viordash/PSoC5-PowerSupplyUnit/README.md

# PowerSupplyUnit PSoC5
Источник питания с микропроцессорным управлением, процессор PSoC® 5LP: CY8C5888LTI-LP097

[схема!](PSoC5_PowerSuplyUnit_Schematic.pdf)

Основные возможности блока питания:
- Два режима работы:

    - Стабилизация выходного напряжения.
    - Стабилизация выходного тока.

- Дискретность по напряжению - 0.01 В.
- Дискретность по току - 0.001 А.
- Выходное напряжение, 2 канала по 0-15 В.
- Максимальный выходной ток, до 8 А.

Управление с передней панели и с помощью манипулятора "мышь" PS/2
Отображение информации на графическом LCD дисплее 240x128 точек

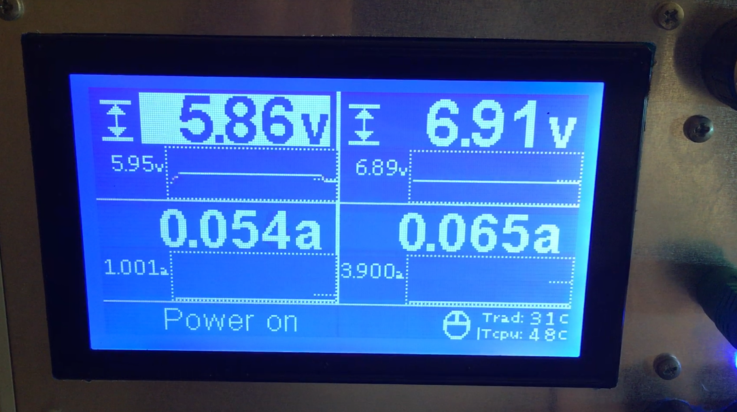
[picture p1: Photo/front panel.png]
front-panel
