viordash/PSoC5-PowerSupplyUnit/Photo/IMG_0879.JPG

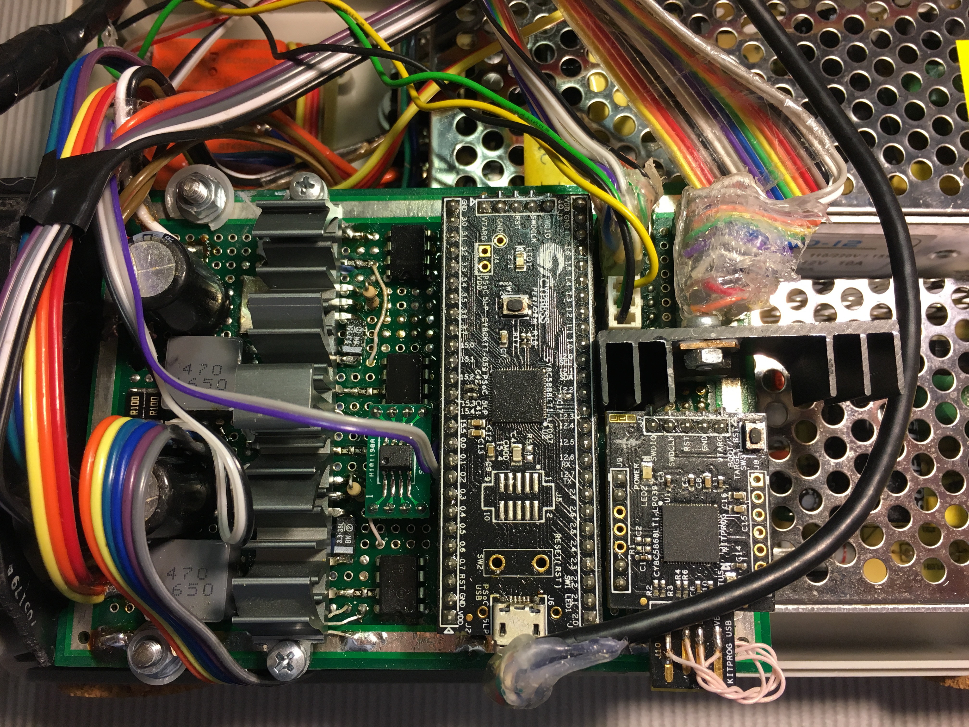
Photo/IMG_0879.JPG
