viordash/PSoC5-PowerSupplyUnit/Photo/IMG_0955.JPG

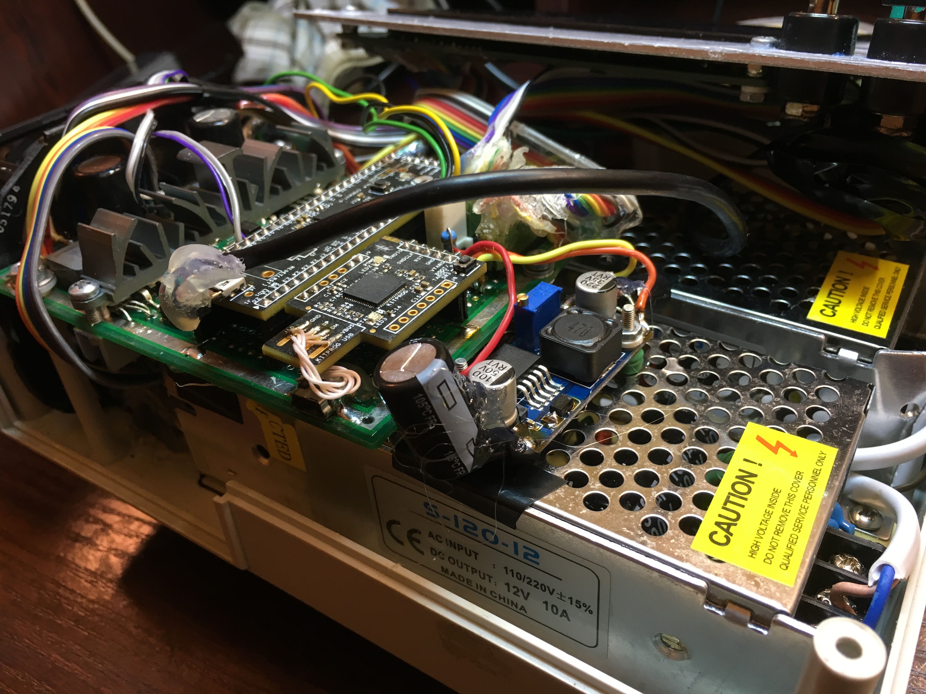
Photo/IMG_0955.JPG
