viordash/PSoC5-PowerSupplyUnit/Photo/IMG_0956.JPG

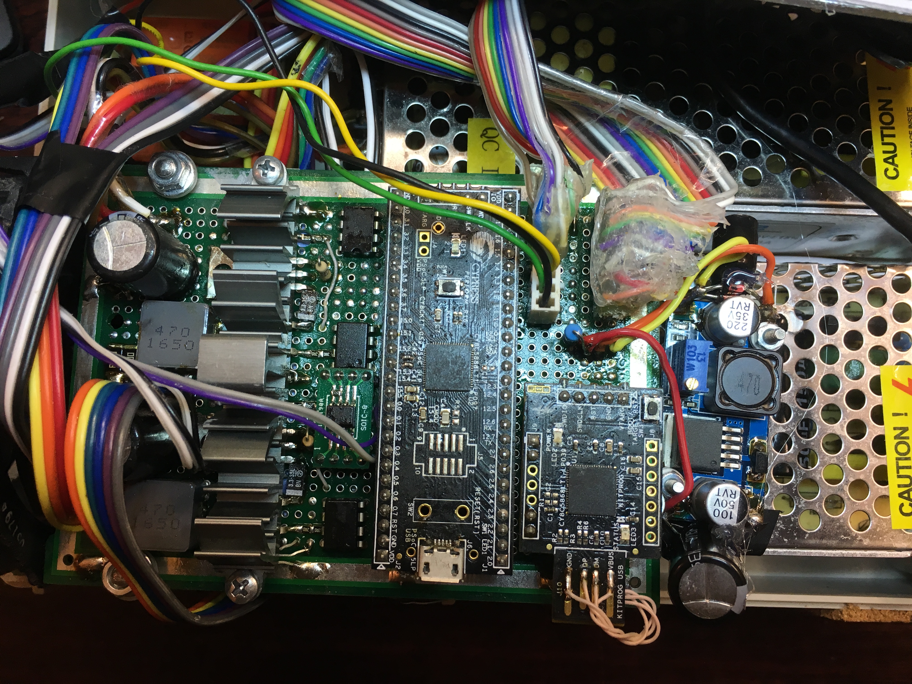
Photo/IMG_0956.JPG
