viordash/PSoC5-PowerSupplyUnit/(list of files, cad)

Other CAD files:
front panel.dwg
