viordash/PSoC5-PowerSupplyUnit/front panel-Model.pdf

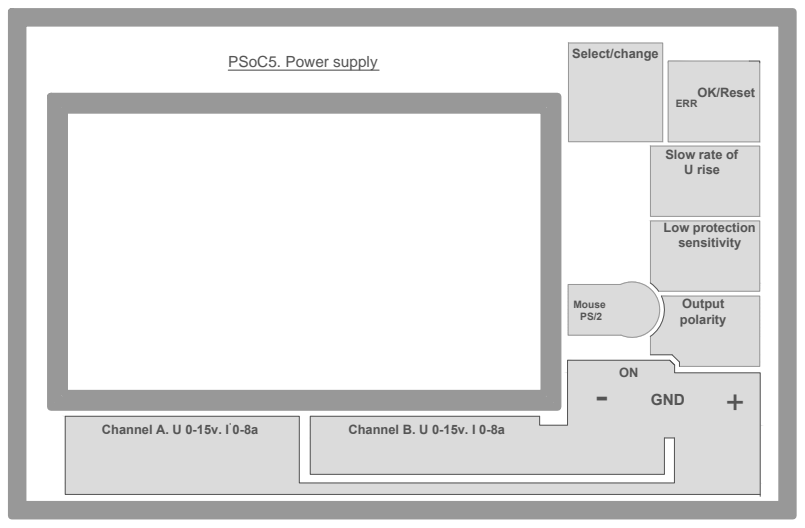
[picture p9: page 1]
- GND; + OK/Reset ERR Slow rate of U rise Low protection sensitivity Output polarity Mouse PS/2; ON Channel A. U 0-15v. I 0-8a; Channel B. U 0-15v. I 0-8a PSoC5. Power supply; Select/change
