viordash/PSoC5-PowerSupplyUnit/PSoC_Creator/PSU_PSoC5/OneWire.cylib/OneWire/OneWire.pdf

# OneWire V0.0(test)

# Резюме

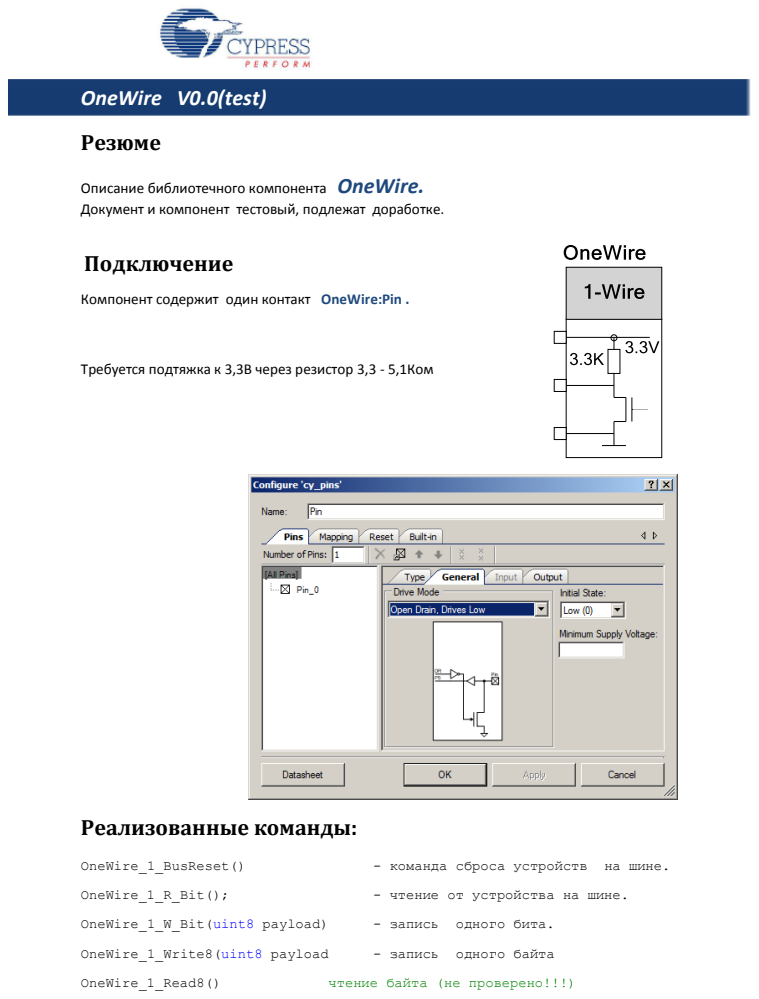
[picture p18: page 1]
Подключение; Реализованные команды:; OneWire_1_BusReset(); - команда сброса устройств; на шине.; OneWire_1_R_Bit();; - чтение от устройства на шине.; OneWire_1_W_Bit(uint8 payload); - запись; одного бита.; OneWire_1_Write8(uint8 payload; одного байта; OneWire_1_Read8(); чтение байта (не проверено!!!)

Описание библиотечного компонента OneWire.
Документ и компонент тестовый, подлежат доработке.

Компонент содержит один контакт OneWire:Pin .

Требуется подтяжка к 3,3В через резистор 3,3 - 5,1Ком
