viordash/PSoC5-PowerSupplyUnit/PSoC_Creator/PSU_PSoC5/PowerSuplyUnit.cydsn/Regulator/CalcAdcValue.c

/* ========================================
 *
 * Copyright YOUR COMPANY, THE YEAR
 * All Rights Reserved
 * UNPUBLISHED, LICENSED SOFTWARE.
 *
 * CONFIDENTIAL AND PROPRIETARY INFORMATION
 * WHICH IS THE PROPERTY OF your company.
 *
 * ========================================
*/

#include <stdio.h>
#include <stdlib.h>
#include "Regulator\CalcAdcValue.h"

INT CalcDisplayValueVoltageA (TElectrValue value) {
    INT val = ADC_VoltageA_CountsTo_mVolts(value);
    if (val < 0) {
        val = 0;    
    } else {        
        val *= 8;   
        val /= 10;  
    }
    return val;
}

TElectrValue CalcSetPointValueVoltageA (TElectrValue value) {  
    INT val = value * 10;    
    val /= 8; 
    TElectrValue adcCounts = ((val * ADC_VoltageA_countsPer10Volt) - (ADC_VoltageA_countsPer10Volt / 2)) / ADC_VoltageA_10MV_COUNTS;
    
    adcCounts += ADC_VoltageA_offset;
    if (adcCounts < 0) {
        adcCounts = 0;    
    }
//      int  mVolts = (int16)( (( (int32)adcCounts * ADC_VoltageA_10MV_COUNTS ) + 
//    ( (adcCounts > 0) ?  (ADC_VoltageA_countsPer10Volt / 2) : (-(ADC_VoltageA_countsPer10Volt / 2)) )) / ADC_VoltageA_countsPer10Volt);  
    return adcCounts;
}

INT CalcDisplayValueAmperageA (TElectrValue value) {
    ADC_Amperage_SetOffset(GetAdcOffsetAmperageA());
    ADC_Amperage_SetGain(GetAdcGainAmperageA());
    INT val = ADC_Amperage_CountsTo_uVolts(value);
    if (val < 0) {
        val = 0;    
    } else {        
        val *= 20;   
        val /= 1000;  
    }
    return val;
}

INT CalcDisplayValueVoltageB (TElectrValue value) {
    INT val = ADC_VoltageB_CountsTo_mVolts(value);
    if (val < 0) {
        val = 0;    
    } else {        
        val *= 8;   
        val /= 10;  
    }
    return val;
}

TElectrValue CalcSetPointValueVoltageB (TElectrValue value) {       
    INT val = value * 10;    
    val /= 8; 
    TElectrValue adcCounts = ((val * ADC_VoltageB_countsPer10Volt) - (ADC_VoltageB_countsPer10Volt / 2)) / ADC_VoltageA_10MV_COUNTS;
    
    adcCounts += ADC_VoltageA_offset;
    if (adcCounts < 0) {
        adcCounts = 0;    
    }
    return adcCounts;
}

INT CalcDisplayValueAmperageB (TElectrValue value) {
    ADC_Amperage_SetOffset(GetAdcOffsetAmperageB());
    ADC_Amperage_SetGain(GetAdcGainAmperageB());
    INT val = ADC_Amperage_CountsTo_uVolts(value);
    if (val < 0) {
        val = 0;    
    } else {        
        val *= 20;   
        val /= 1000;  
    }
    return val;
}

TElectrValue CalcSetPointValueAmperage (TElectrValue value) {   
    int32 coefA;
    int32 coefB;  
    INT val = value * 1000;
    val /= 20;    
    /* ADC_Amperage__BITS_14 */ 
    coefA = ADC_Amperage_1UV_COUNTS / ADC_Amperage_DIVISOR_8;
    coefB = ADC_Amperage_DIVISOR_8;    
    coefB = ADC_Amperage_CountsPerVolt / coefB;
   // uVolts = ((coefA * adcCounts) / coefB) - ((coefA * ADC_Amperage_Offset) / coefB);    
    TElectrValue adcCounts = ((coefB * val) / coefA) + ADC_Amperage_Offset;    
    if (adcCounts < 0) {
        adcCounts = 0;    
    }    
    return adcCounts;
}

/* [] END OF FILE */
