viordash/PSoC5-PowerSupplyUnit/(commit log)

2017-05-01 Schematic for power part
2017-05-01 update schematic
2017-05-08 Develope & draw schematic in PSoC Creator
2017-05-14 MicroCap. Voltage amplifier to single polarity
2017-05-14 MicroCap. update current measure sch
2017-05-21 add front panel drawing
    [front panel.dwg]
2017-05-31 replace Delay_nS with Display_TaskSleepZero
    [LCD_Display.h, LCD_T6963.c]
2017-05-31 fix bug with tale mask in case of additional byte requried in PutDataInGraphicBuffer
    [LCD_T6963.c]
2017-05-31 add feature for inverting color when printing
    [LCD_Display.c, LCD_T6963.c, LCD_T6963.h]
2017-06-04 buttons control processing
2017-06-08 spike for process encoder in UDB
2017-06-08 review reset timer
2017-06-12 fix wrong LCD text out with invert color
    [LCD_T6963.c]
2017-06-18 restore the focused frame on current focused after select timeout
2017-06-18 add temperature indicator && remove leading zero in electr values
2017-06-19 add TemperatureControl & review the temperature displaying
2017-06-20 add proportional small font for temperature out
2017-06-20 skip spontaneous errors in a temperature sensors
    [LCD_Display.c, ValueIndicator.c, device.h]
2017-06-20 start of mouse driver implementing
2017-06-21 mouse driver. WIP
2017-06-26 fix GetElapsedPeriod in case when GetTickCount() == fromTickCount
2017-06-26 Mouse driver fix for recieve count in MSMode_StateReset. Add LogicAnalyzer files
2017-06-26 fix ElectrValue changing from mouse wheel
2017-06-26 fix GetElapsedPeriod in case when GetTickCount() < fromTickCount
2017-06-26 add separator line for temperature indicators
2017-06-26 repaint the display when switch screen type
2017-06-27 fix switching screen
2017-07-09 attempt for analog schematic for measuring values
2017-07-11 update schematic with locking Analog part
2017-07-12 start of regulator functionality
2017-07-16 regulator functionality. WIP.
2017-07-22 fix refreshing of the Display
    [LCD_Display.c, LCD_Display.h, MainWork.c]
2017-07-22 regulator functionality. SetPoint change
2017-07-23 showing the error messages
    [LCD_Display.c, LCD_Display.h, MainWork.c, main.c]
2017-07-30 fix wrong ADC chanek
    [RegulatorTask.c]
2017-07-30 start of ADC conversion
2017-07-30 add offset measure for VoltageA
2017-07-30 fix starting of ChanelB & fix wrong ADC chanel
    [RegulatorTask.c]
2017-07-30 fix wrong ADC chanel
    [RegulatorTask.c]
2017-07-30 fix PWM initialization
2017-07-30 review PWM value calculation
2017-07-31 fix software OverVolatge & OverCurrent
    [MainWork.c, RegulatorTask.c]
2017-07-31 review showing the Over Voltage/Amperage errors
    [LCD_Display.c, LCD_Display.h, MainWork.c, MainWork.h, RegulatorTask.c, device.h]
2017-08-01 display the current WorkState
2017-08-03 Main power on. Testing the PWM
2017-08-06 regulator PWM freq to 30 KHz for increase regulating steps
2017-08-08 fix measuring Voltage/Amperage on channelB
    [RegulatorTask.c]
2017-08-08 fix Voltage/Amperage measuring & indicating on channelA
    [LCD_Display.c, RegulatorTask.c, ValueIndicator.c, ValueIndicator.h]
2017-08-09 complex review of measuring/displaying Voltage/Amperage
2017-08-09 draw snubber on schematic
2017-08-10 join measuring for Amperage A-B in a single ADC. ADC VolatageB now is only for voltage
2017-08-10 add PWM for LCD backLight
2017-08-10 temperature-fan pwm control
2017-08-15 Add intermediate working state for delays when the relay is turned on
2017-08-23 Regulating. add limiting of output voltage by hw comparator
2017-08-23 Temporary remove diff amplifier for VoltageA. Enable regulating for channel B
2017-08-24 improve the PWM steps count with including the last "1" impulse from bus_clk when PWM is failng down
    [MainWork.c, RegulatorTask.c, device.h]
2017-08-28 add OperAmplifier (LM258.2) for measuring the VoltageA
2017-08-29 Regulating. Using the extended 1step in PWM
2017-08-29 change button "PolarMode" functionality to Protective Behavior
2017-08-29 Display. Skip multiple RequestToErrorOver
    [LCD_Display.c]
2017-08-31 improve schematic. WIP
2017-09-03 protection. In a TopDesign add junction for switch off also the OnChB in case OverAmperA
2017-09-03 freeze the last Voltage/Amperage values if protection is worked
2017-09-03 review cleaning the errors state
    [MainWork.c]
2017-09-03 fix displaing the work states after errors
    [LCD_Display.c, LCD_Display.h, MainWork.c, RegulatorTask.c]
2017-09-03 stabilize by amperage. WIP
    [RegulatorTask.c]
2017-09-05 fix display frozen value when protect triggerd
    [LCD_Display.c]
2017-09-06 add feature for switch the protection sensitivity
2017-09-06 component ADC SAR update
2017-09-06 Chart for Voltage/Amperage. WIP
2017-09-12 fix frequently updates MeasuredValues
    [LCD_Display.c]
2017-09-12 switching of the decimal point, depending on its value in the indicators of the Measured Amperage
2017-09-13 fix overflow int16 in CalcSetPointValueVoltageX
    [CalcAdcValue.c]
2017-09-13 Button Ok for reset errors. Activate Led_Error
    [MainWork.c]
2017-09-13 fix buttons reading
2017-09-13 activate Button On Or ChangePolarity
2017-09-17 update front panel drawing.. WIP
    [front panel.dwg]
2017-09-18 fix low changing rate when regulating
    [RegulatorTask.c]
2017-09-19 redraw schematic
2017-09-19 add protection by temperatures over range
2017-09-20 add feature for entering power save mode
2017-09-21 change order of changing state of WorkMode and switching off output
2017-09-24 update front panel drawing
    [front panel.dwg]
2017-10-02 add SPICe sheet for half-bridge pwm
2017-10-04 implementing the 4 bit dither in a PWM. Increase the PWM flexibility to 1024 * 4 = 4096 steps
2017-10-05 measuring AdcVoltage with DMA. With median filtering
2017-10-08 review checks DMA finish ststus. Enable chanel B
2017-10-09 limiting of RegulatorObj.Chanelx.Voltage.Pwm values
2017-10-12 set Adc sample rate to 500000 sps
2017-10-12 fix major bug. Undefined pointers when calling MouseHandler
    [MainWork.c]
2017-10-12 fix major bug. Overflow the HW protection values
    [RegulatorTask.c]
2017-11-20 RegulatorTask. Calc the precalculated values on init
2020-09-20 add schematic
