viordash/PSoC5-PowerSupplyUnit/Photo/IMG_0873.JPG

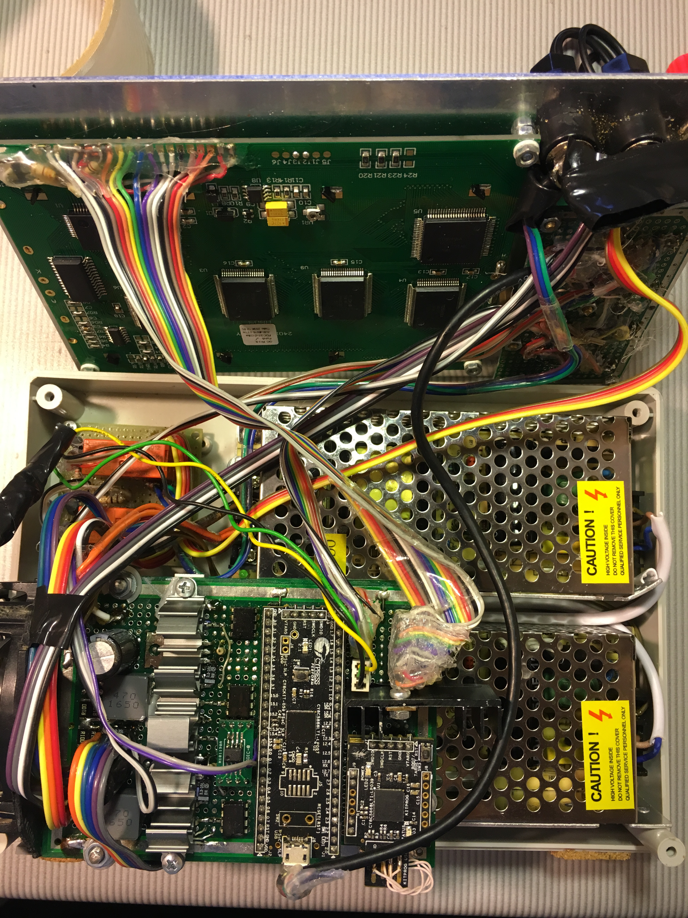
Photo/IMG_0873.JPG
