viordash/PSoC5-PowerSupplyUnit/Photo/IMG_0874.JPG

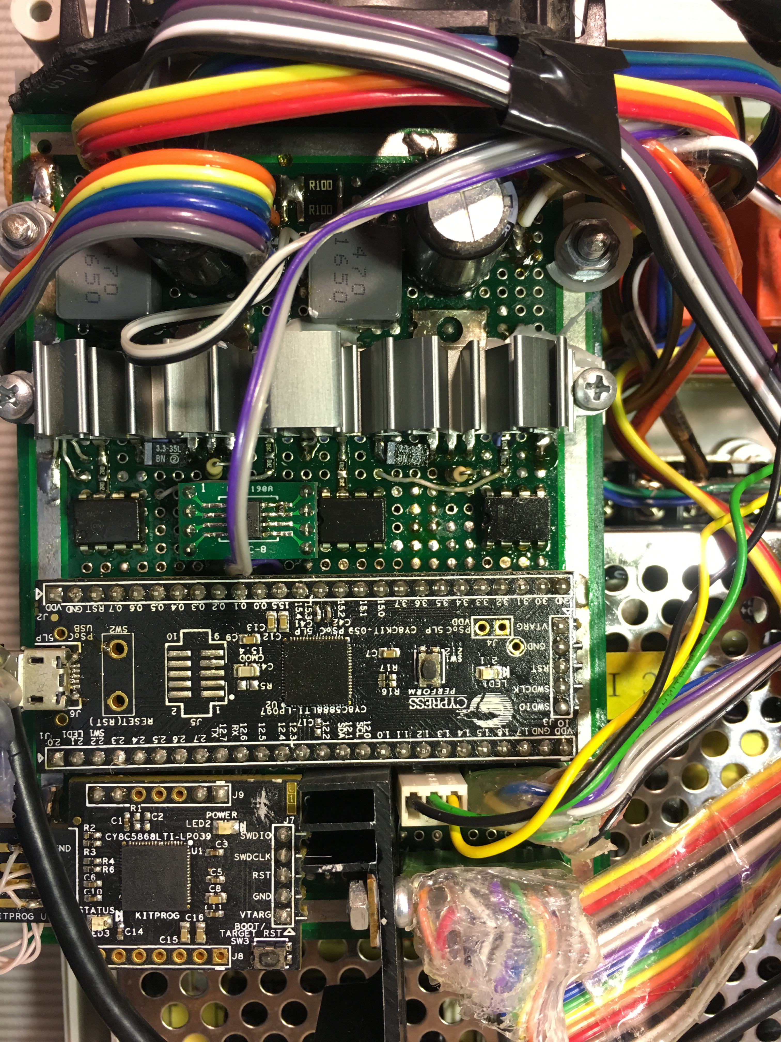
Photo/IMG_0874.JPG
