viordash/PSoC5-PowerSupplyUnit/Photo/IMG_0910.JPG

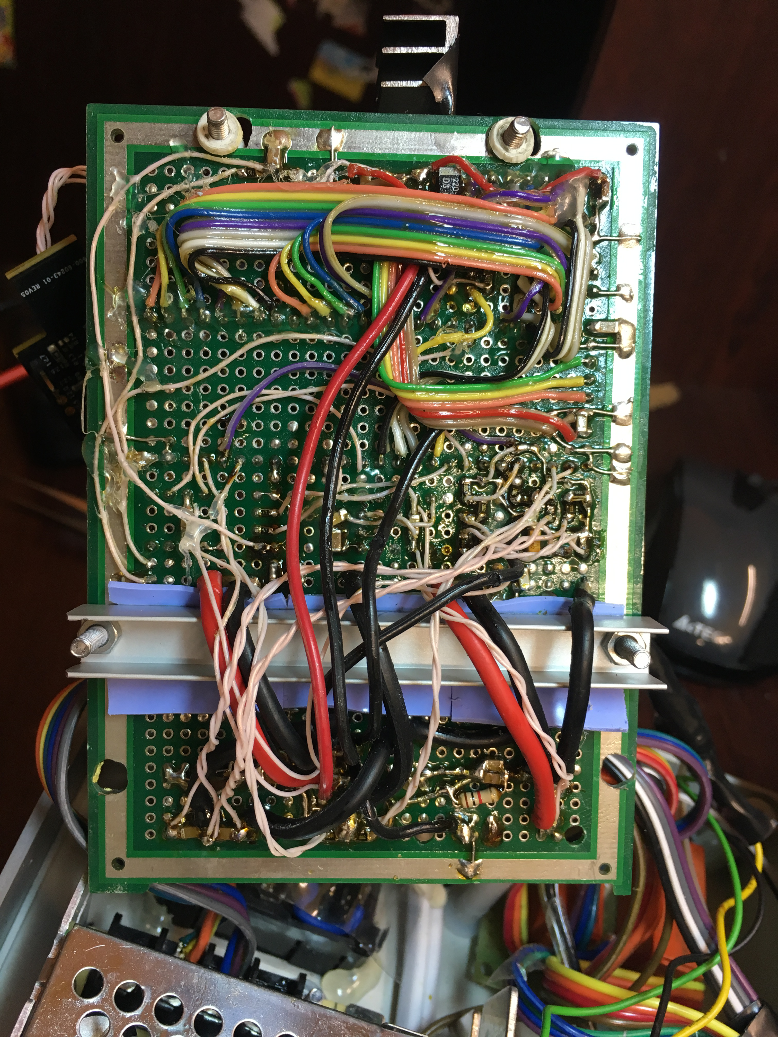
Photo/IMG_0910.JPG
