viordash/PSoC5-PowerSupplyUnit/Photo/IMG_0953.JPG

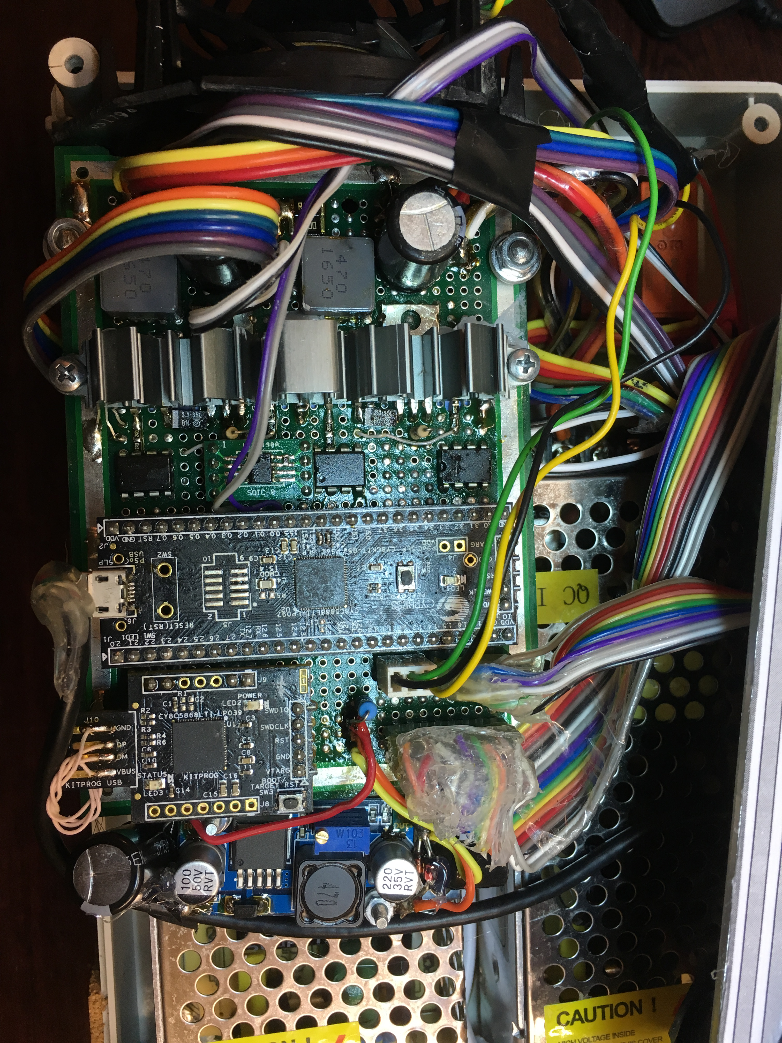
Photo/IMG_0953.JPG
